webradiocontrol/wrc-morse-key-adapter/(list of files, drawings)

Other design files:
hardware/wrc-morse-key-adapter-schematic-easyeda-v1_1.json
