webradiocontrol/wrc-morse-key-adapter/(commit log)

2020-10-13 Rename schematic file
2020-10-25 Use pin 6 for CW side-tone PWM output by default to support Arduino Pro Micro
2020-11-12 Add support for Arduino Pro Micro
2020-12-13 Add new firmware binary HEX files for both Arduino Micro and Pro Micro
2020-12-14 Do not use pin 11, as it is not present on Arduino Pro Micro
2021-01-26 Update schematic and documentation to match latest source code for version 1.1 of the adapter
    [wrc-morse-key-adapter-schematic-easyeda-v1_1.json]
